jonmon6691/LoRa-Latch/(commit log)

2020-10-18 Add wiring diagram
2020-11-01 Added info on the capacitor
2020-11-01 Updated wiring, added photo
2020-11-01 Had to rewire because it turns out the 5v relay is polarized
2020-11-02 Improve timer overflow logic
    There is more improvement to be had here, but this is much better than nothing, and now radio_unlock has overflow protection.
2020-11-25 Calibrated the door hold time. It appears that the latch is actually open longer than just when the button is beng pressed. 1 second is much nicer.
2020-11-25 Battery powered remote!
